JamieTaylor23/Adjustabike/Cargo Attachment/README

Contains all joints for cargo attachment
