JamieTaylor23/Adjustabike/Front Fork/Front Fork/Fork Crown main.stp

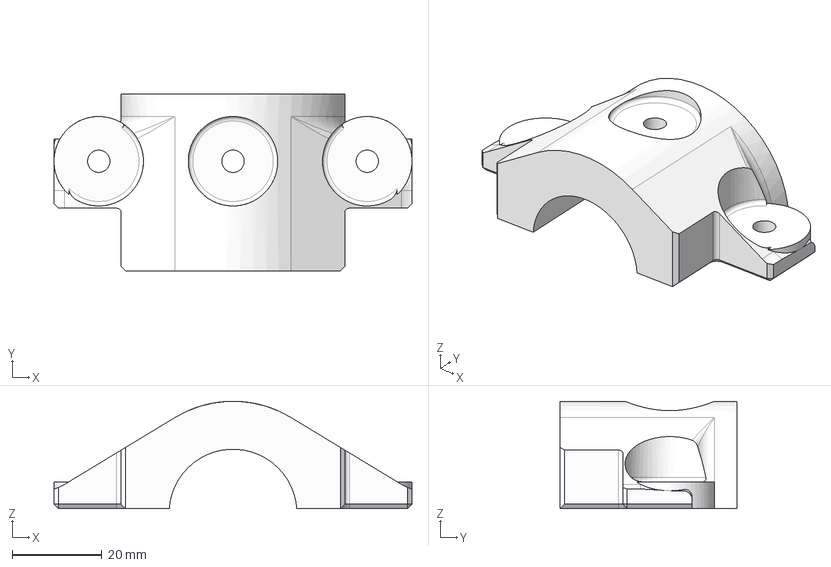
[picture p5: CAD file, 2019-04-16]
Front Fork/Front Fork/Fork Crown main.stp
80.0 x 39.5 x 24.0 mm
