JamieTaylor23/Adjustabike/Cargo Attachment/Cargo Attachment/Bottom Plate.stp

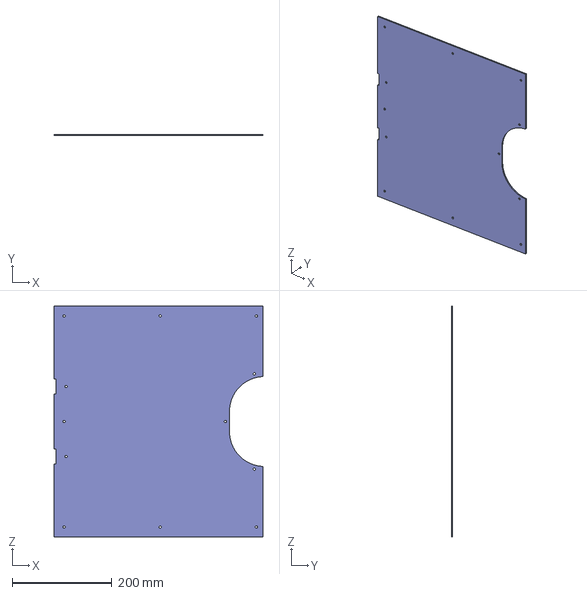
[picture p6: CAD file, 2019-04-16]
Cargo Attachment/Cargo Attachment/Bottom Plate.stp
418.0 x 3.00 x 462.2 mm
