JamieTaylor23/Adjustabike/Down Tube Assembly/Down Tube Assembly/middle adjustable connector.stp

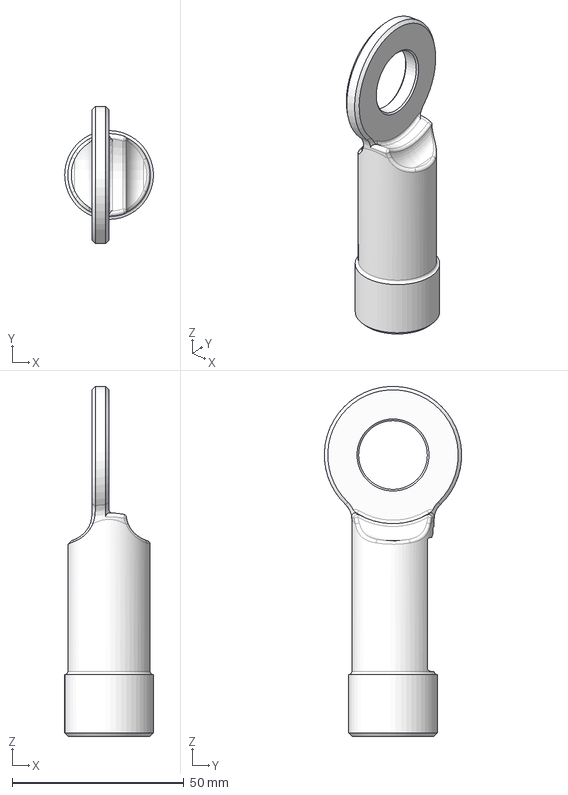
[picture p7: CAD file, 2019-04-16]
Down Tube Assembly/Down Tube Assembly/middle adjustable connector.stp
25.8 x 40.0 x 102.0 mm
