JamieTaylor23/Adjustabike/Front Fork/Front Fork/fork end right.stp

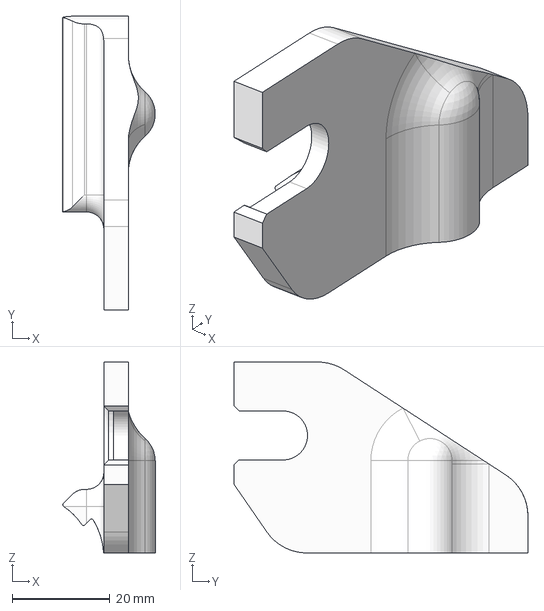
[picture p8: CAD file, 2019-04-16]
Front Fork/Front Fork/fork end right.stp
18.9 x 60.0 x 39.0 mm
