JamieTaylor23/Adjustabike/Profiles/Profiles/Large Tube End.stp

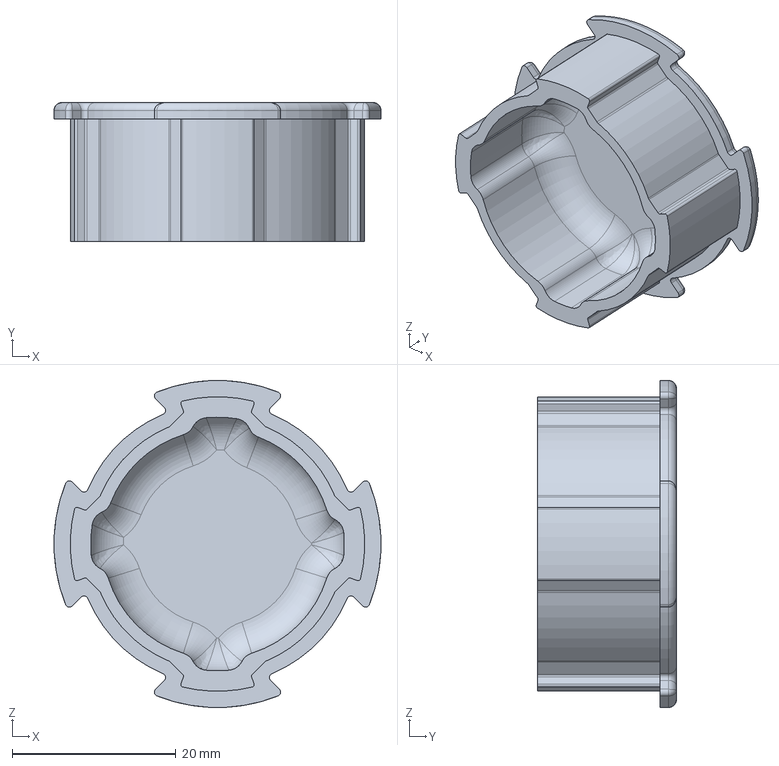
[picture p9: CAD file, 2019-04-16]
Profiles/Profiles/Large Tube End.stp
40.0 x 17.0 x 40.0 mm
