JamieTaylor23/Adjustabike/Rear Triangle/Rear Triangle/Rear Dropouts right clamp.stp

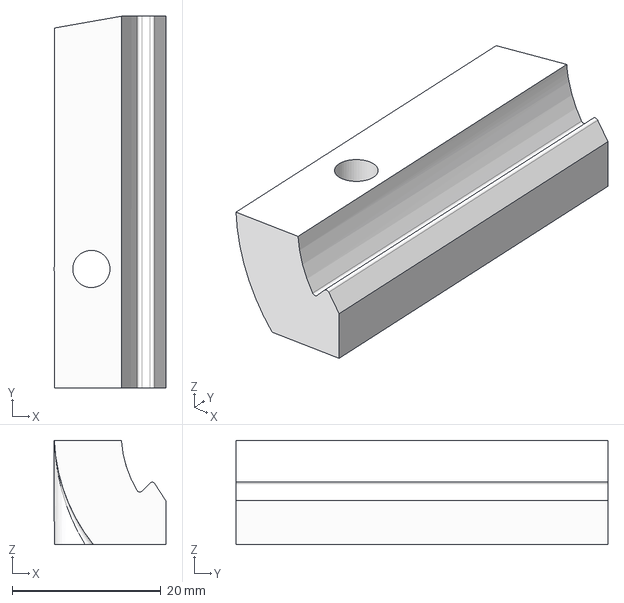
[picture p10: CAD file, 2019-04-16]
Rear Triangle/Rear Triangle/Rear Dropouts right clamp.stp
15.0 x 50.0 x 14.0 mm
