JamieTaylor23/Adjustabike/Seat Tube Assembly/Seat Tube Assembly/bottom bracket to head tube left.stp

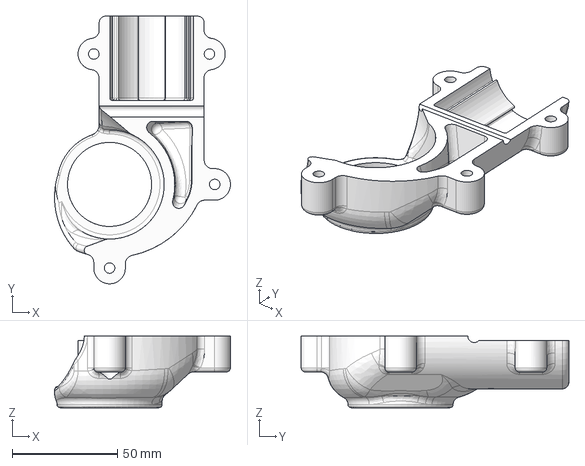
[picture p11: CAD file, 2019-04-16]
Seat Tube Assembly/Seat Tube Assembly/bottom bracket to head tube left.stp
83.7 x 127.3 x 34.0 mm
