JamieTaylor23/Adjustabike/Seat Tube Assembly/standard joint.stp

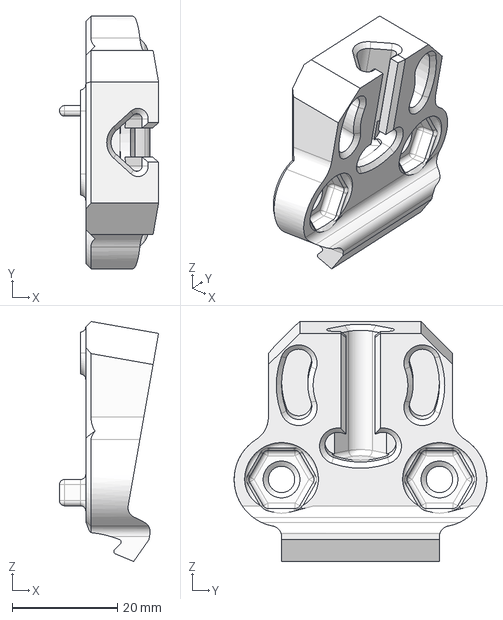
[picture p12: CAD file, 2019-04-16]
Seat Tube Assembly/standard joint.stp
18.8 x 48.0 x 45.6 mm
