JamieTaylor23/Adjustabike/Cargo Attachment/Cargo Attachment/plate support.stp

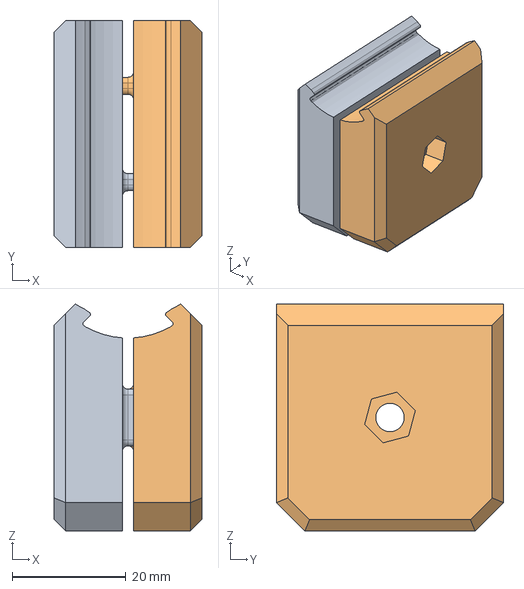
[picture p13: CAD file, 2019-04-16]
Cargo Attachment/Cargo Attachment/plate support.stp
26.0 x 40.0 x 40.0 mm
