JamieTaylor23/Adjustabike/Down Tube Assembly/Down Tube Assembly/Head Tube Mount.stp

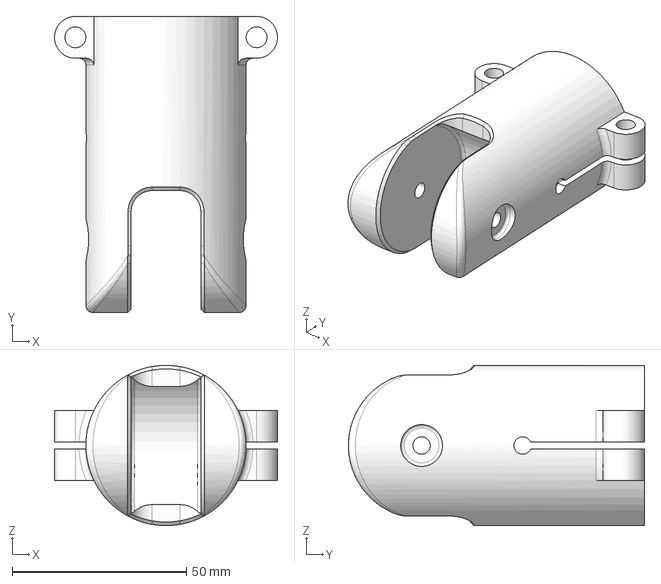
[picture p14: CAD file, 2019-04-16]
Down Tube Assembly/Down Tube Assembly/Head Tube Mount.stp
64.0 x 85.0 x 46.0 mm
