JamieTaylor23/Adjustabike/Front Fork/Front Fork/fork end clamp.stp

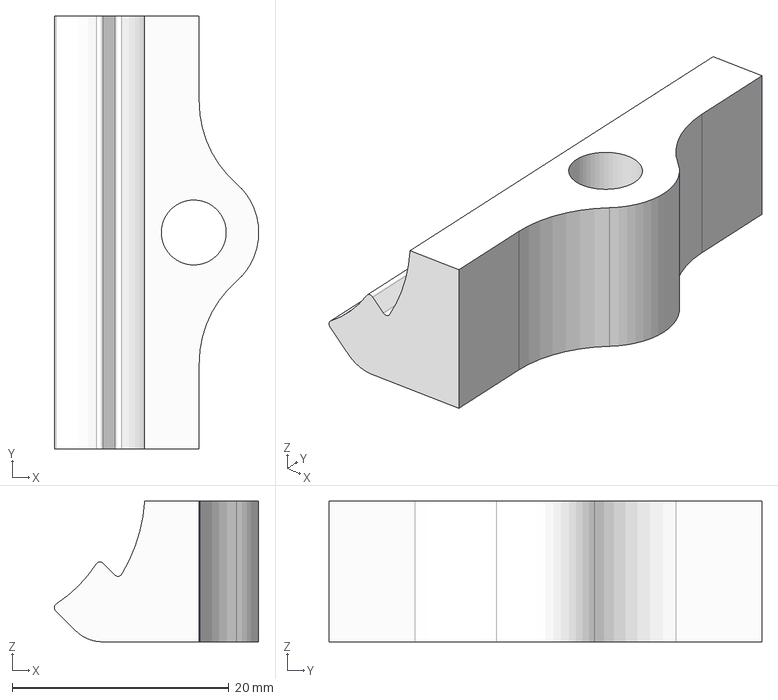
[picture p15: CAD file, 2019-04-16]
Front Fork/Front Fork/fork end clamp.stp
18.9 x 40.0 x 13.0 mm
