JamieTaylor23/Adjustabike/Profiles/Profiles/Handlebar cargo tube.stp

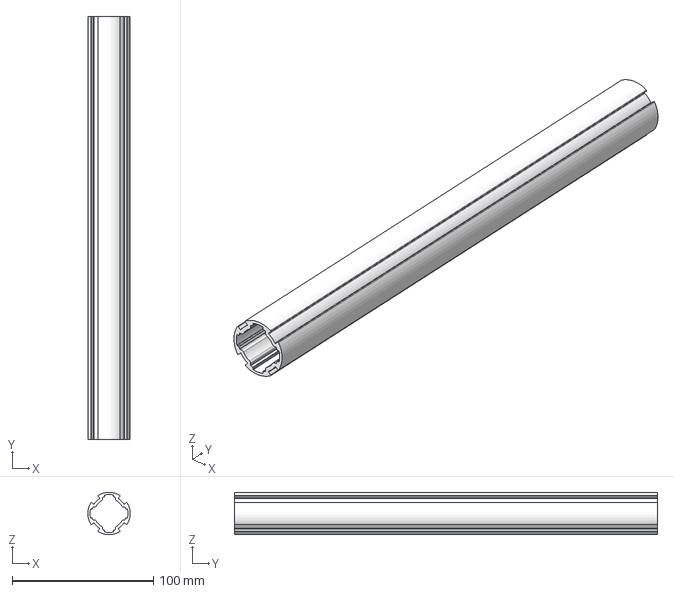
[picture p16: CAD file, 2019-04-16]
Profiles/Profiles/Handlebar cargo tube.stp
29.9 x 300.0 x 29.9 mm
