JamieTaylor23/Adjustabike/Rear Triangle/Rear Triangle/Rear Dropouts left.stp

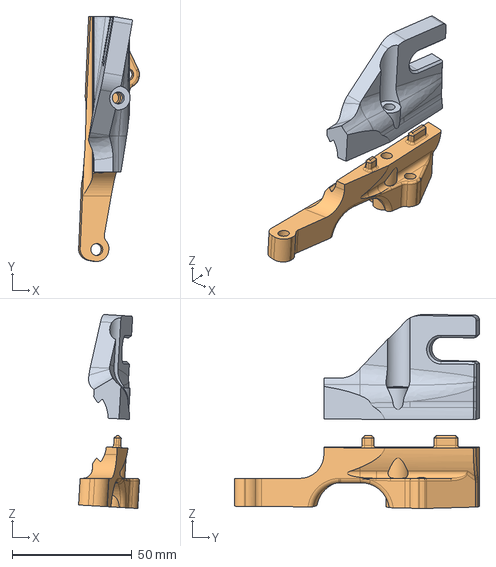
[picture p17: CAD file, 2019-04-16]
Rear Triangle/Rear Triangle/Rear Dropouts left.stp
25.4 x 102.3 x 81.0 mm
