JamieTaylor23/Adjustabike/Seat Tube Assembly/Seat Tube Assembly/Seat tube.stp

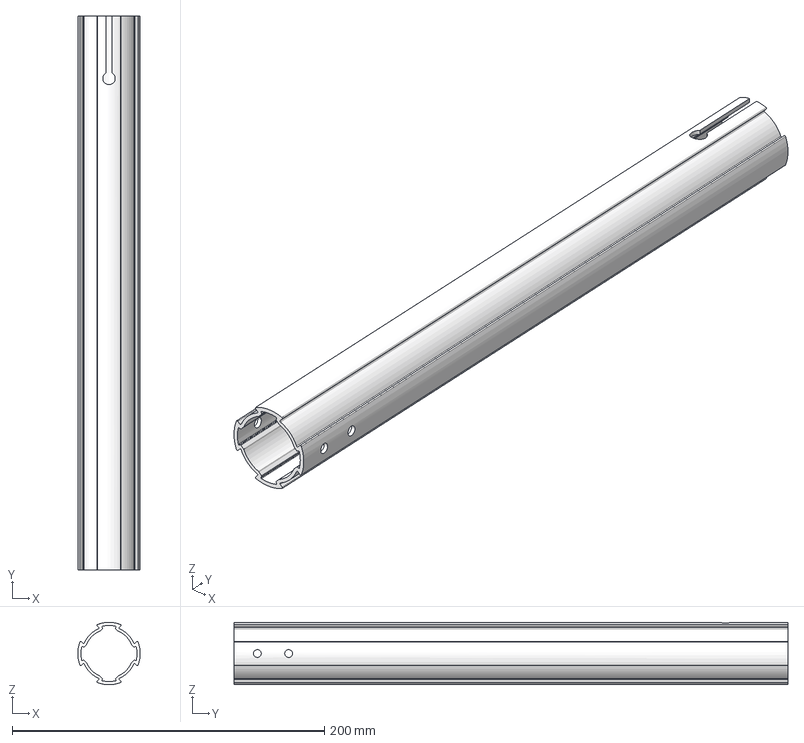
[picture p18: CAD file, 2019-04-16]
Seat Tube Assembly/Seat Tube Assembly/Seat tube.stp
40.0 x 355.0 x 40.0 mm
