JamieTaylor23/Adjustabike/Cargo Attachment/Cargo Attachment/Front plate.stp

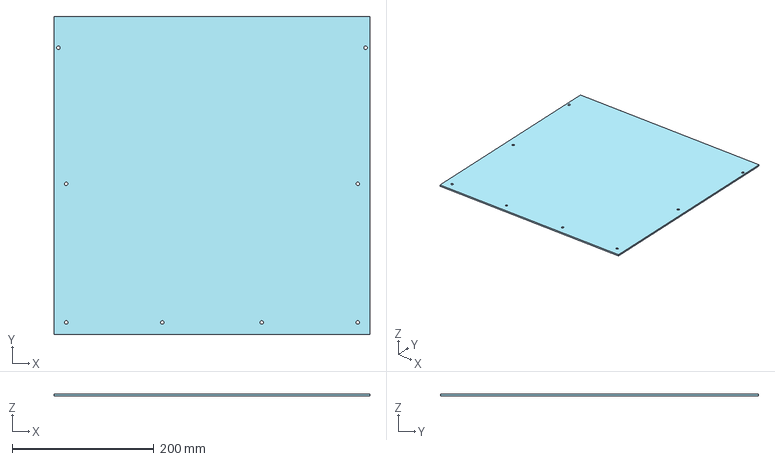
[picture p19: CAD file, 2019-04-16]
Cargo Attachment/Cargo Attachment/Front plate.stp
444.8 x 448.0 x 3.00 mm
