JamieTaylor23/Adjustabike/Down Tube Assembly/Down Tube Assembly/adjustable bar joint.stp

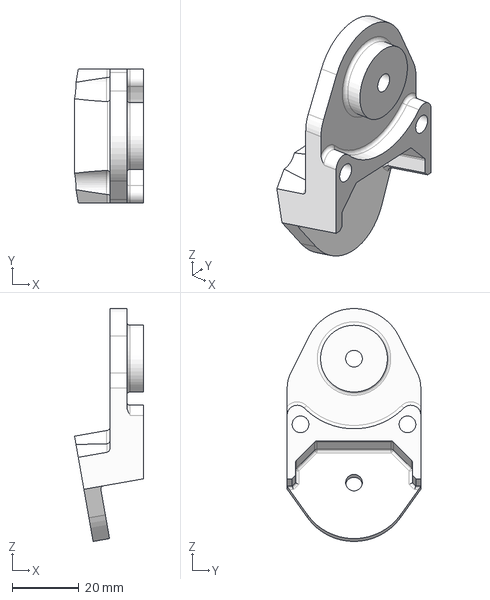
[picture p20: CAD file, 2019-04-16]
Down Tube Assembly/Down Tube Assembly/adjustable bar joint.stp
20.6 x 40.0 x 69.7 mm
