JamieTaylor23/Adjustabike/Front Fork/Front Fork/Fork Crown clamp 3.stp

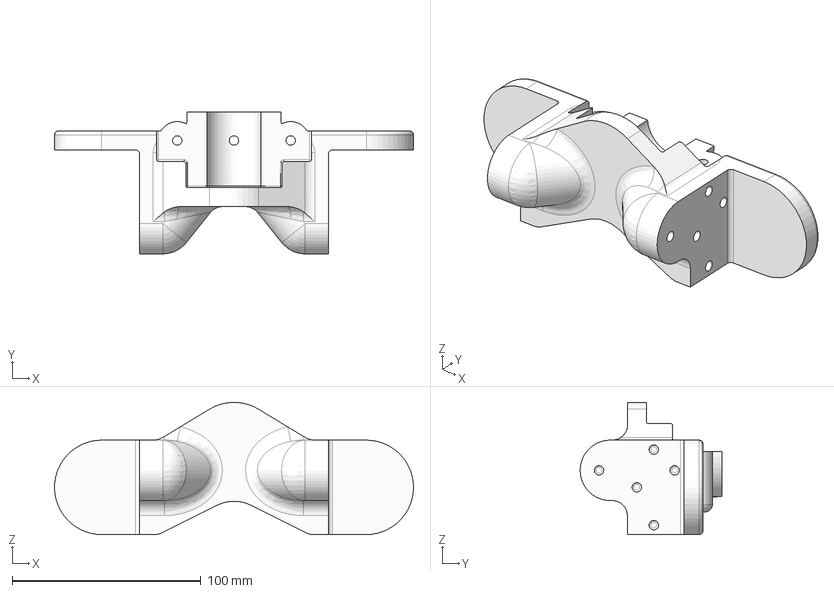
[picture p21: CAD file, 2019-04-16]
Front Fork/Front Fork/Fork Crown clamp 3.stp
190.0 x 75.0 x 70.0 mm
