JamieTaylor23/Adjustabike/Profiles/Profiles/Cargo Long tube.stp

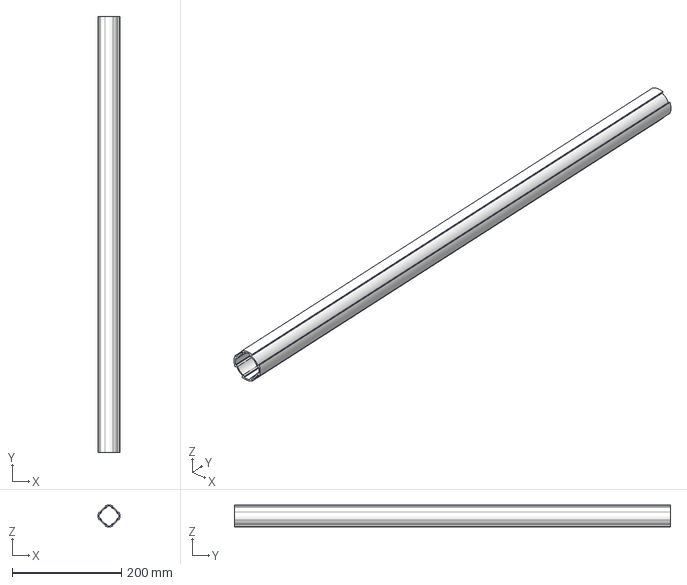
[picture p22: CAD file, 2019-04-16]
Profiles/Profiles/Cargo Long tube.stp
39.9 x 800.0 x 39.9 mm
