JamieTaylor23/Adjustabike/Rear Triangle/Rear Triangle/Rear stay joint.stp

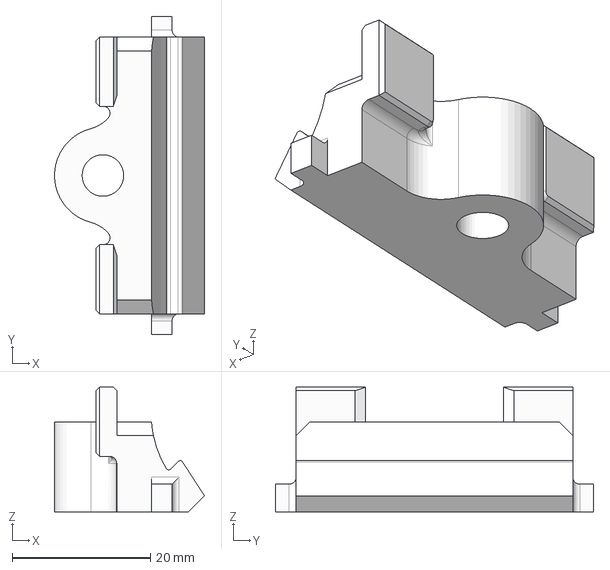
[picture p23: CAD file, 2019-04-16]
Rear Triangle/Rear Triangle/Rear stay joint.stp
21.7 x 46.0 x 18.0 mm
