JamieTaylor23/Adjustabike/Seat Tube Assembly/Seat Tube Assembly/seat tube insert.stp

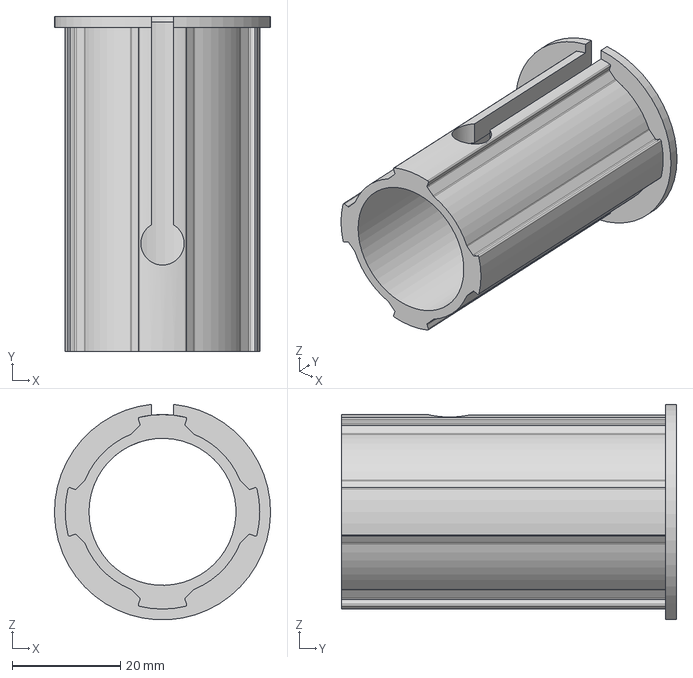
[picture p24: CAD file, 2019-04-16]
Seat Tube Assembly/Seat Tube Assembly/seat tube insert.stp
40.0 x 62.0 x 39.9 mm
