JamieTaylor23/Adjustabike/Cargo Attachment/Cargo Attachment/Plate spacer.stp

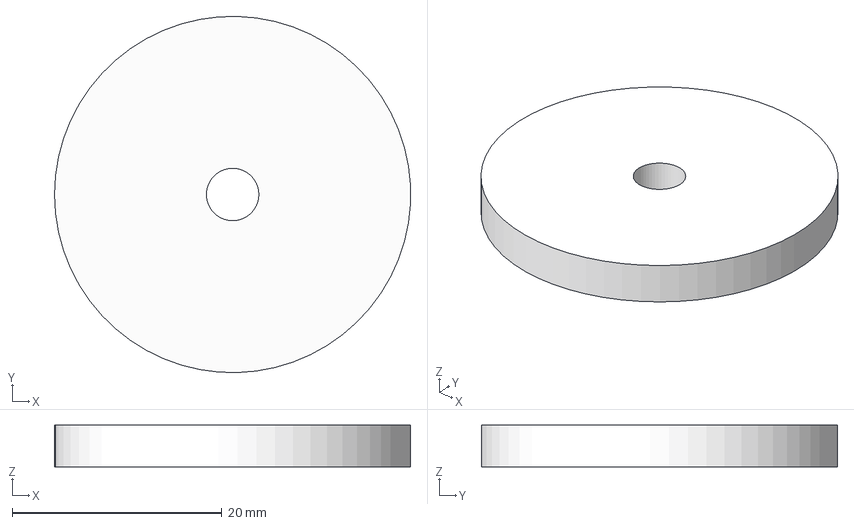
[picture p25: CAD file, 2019-04-16]
Cargo Attachment/Cargo Attachment/Plate spacer.stp
34.0 x 34.0 x 4.00 mm
