JamieTaylor23/Adjustabike/Down Tube Assembly/Down Tube Assembly/Head Tube.stp

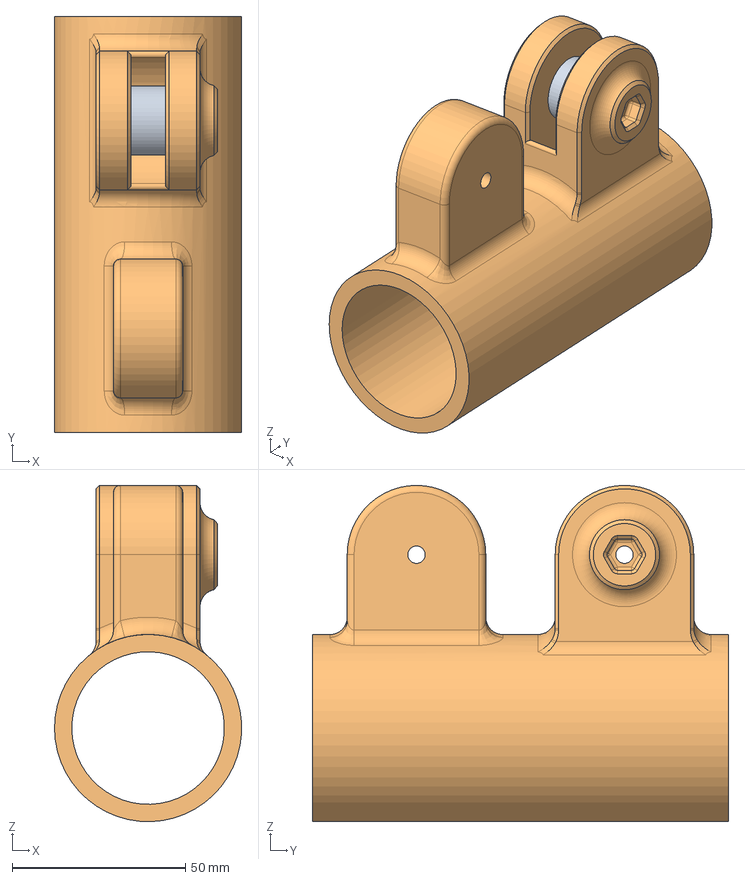
[picture p26: CAD file, 2019-04-16]
Down Tube Assembly/Down Tube Assembly/Head Tube.stp
53.9 x 120.0 x 97.0 mm
