JamieTaylor23/Adjustabike/Front Fork/Front Fork/brake boss clamp.stp

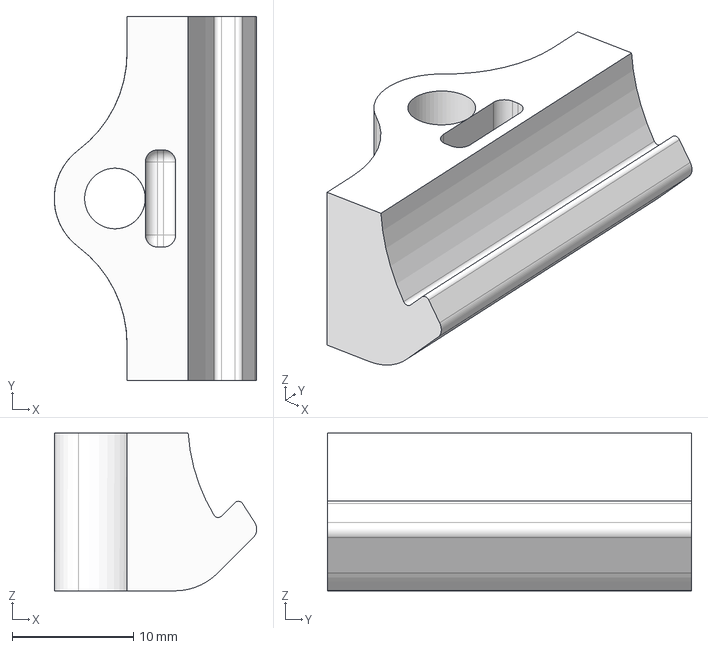
[picture p27: CAD file, 2019-04-16]
Front Fork/Front Fork/brake boss clamp.stp
16.7 x 30.0 x 13.0 mm
