JamieTaylor23/Adjustabike/Profiles/Profiles/Small Tube End.stp

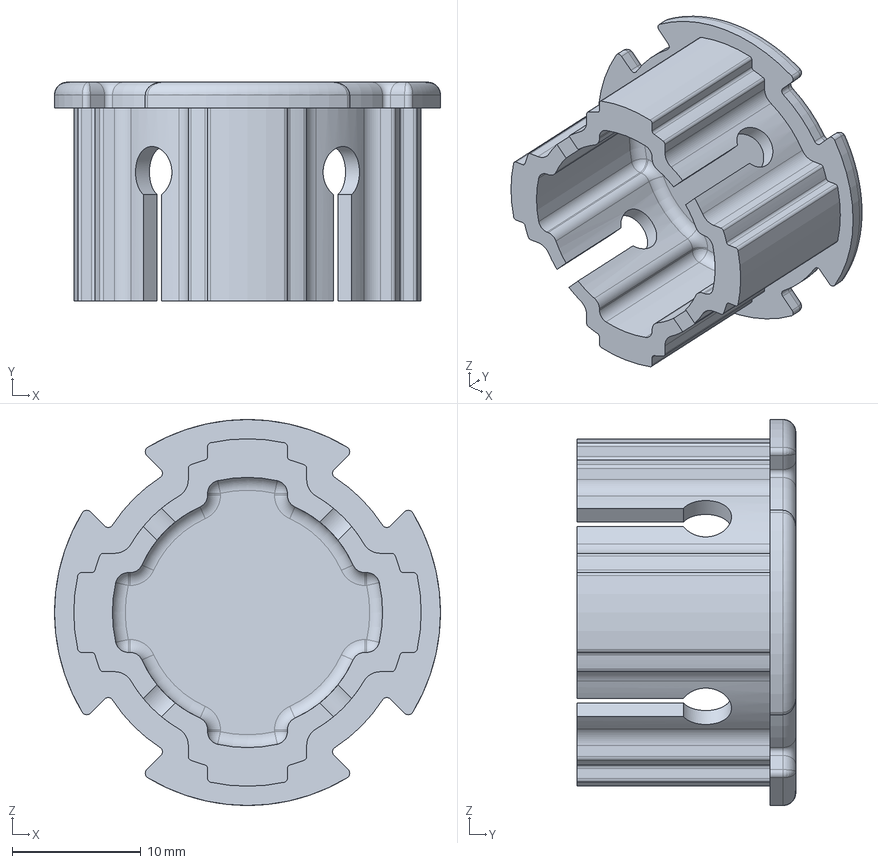
[picture p28: CAD file, 2019-04-16]
Profiles/Profiles/Small Tube End.stp
30.0 x 17.0 x 30.0 mm
