JamieTaylor23/Adjustabike/Rear Triangle/Rear Triangle/Rear Dropouts right.stp

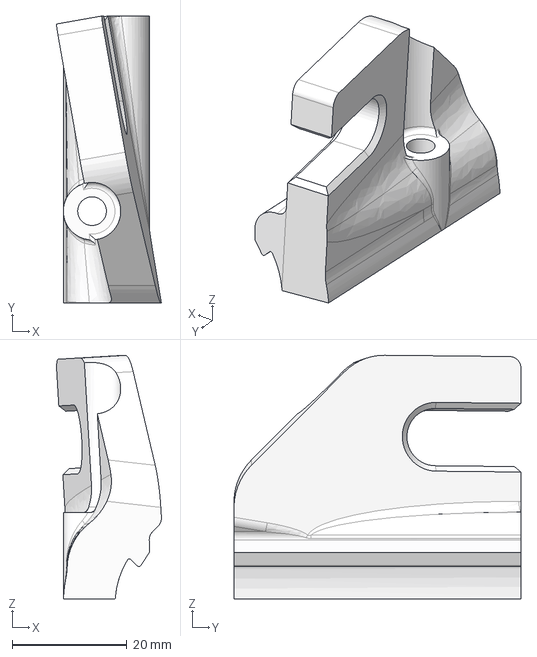
[picture p29: CAD file, 2019-04-16]
Rear Triangle/Rear Triangle/Rear Dropouts right.stp
18.3 x 50.0 x 42.4 mm
