JamieTaylor23/Adjustabike/Seat Tube Assembly/Seat Tube Assembly/bottom bracket.stp

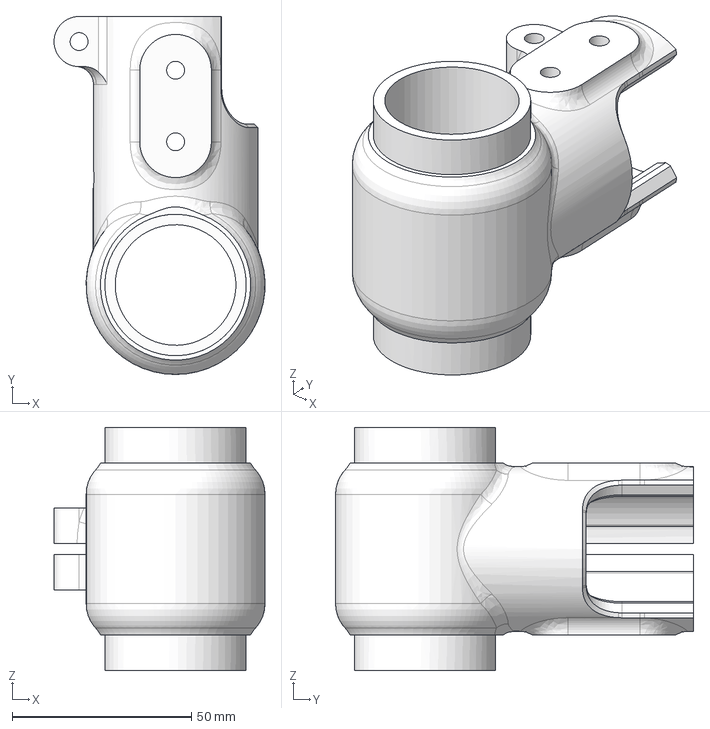
[picture p30: CAD file, 2019-04-16]
Seat Tube Assembly/Seat Tube Assembly/bottom bracket.stp
58.9 x 100.0 x 68.0 mm
