JamieTaylor23/Adjustabike/Cargo Attachment/Cargo Attachment/Step Plate.stp

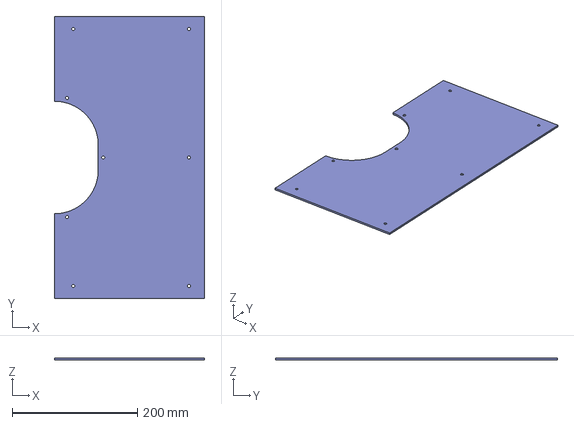
[picture p31: CAD file, 2019-04-16]
Cargo Attachment/Cargo Attachment/Step Plate.stp
240.0 x 451.2 x 3.00 mm
