JamieTaylor23/Adjustabike/Down Tube Assembly/Down Tube Assembly/Head Tube Plug.stp

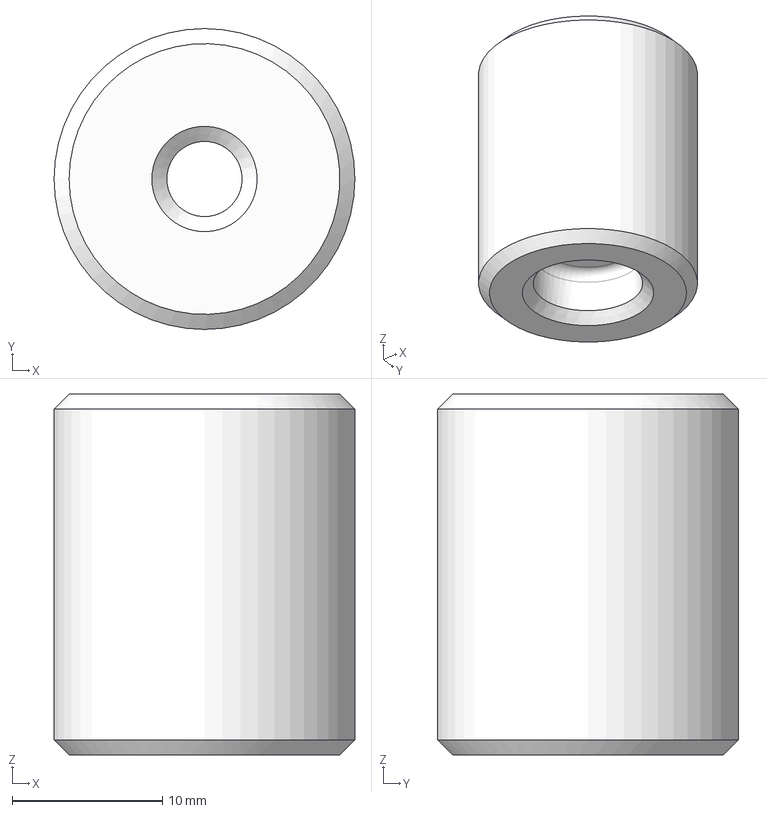
[picture p32: CAD file, 2019-04-16]
Down Tube Assembly/Down Tube Assembly/Head Tube Plug.stp
20.0 x 20.0 x 24.0 mm
