JamieTaylor23/Adjustabike/Profiles/Profiles/450mm tube.stp

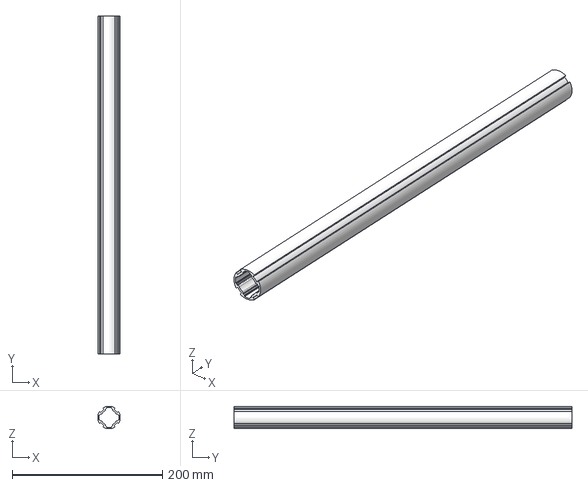
[picture p33: CAD file, 2019-04-16]
Profiles/Profiles/450mm tube.stp
29.9 x 450.0 x 29.9 mm
