JamieTaylor23/Adjustabike/Rear Triangle/Rear Triangle/Rear stay joint clamp.stp

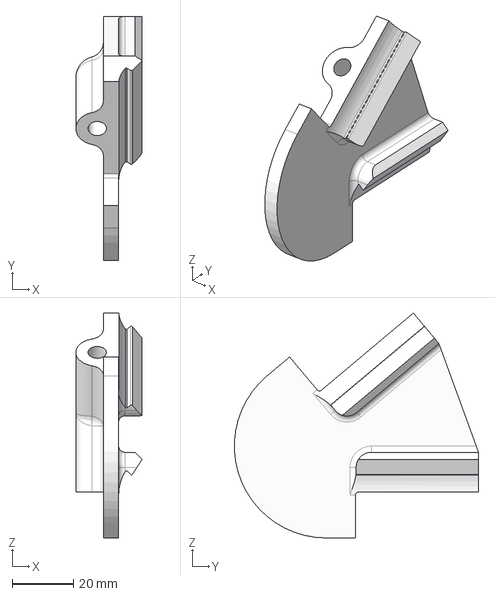
[picture p34: CAD file, 2019-04-16]
Rear Triangle/Rear Triangle/Rear stay joint clamp.stp
21.7 x 79.7 x 73.5 mm
