JamieTaylor23/Adjustabike/Seat Tube Assembly/Seat Tube Assembly/seat stay attachment.stp

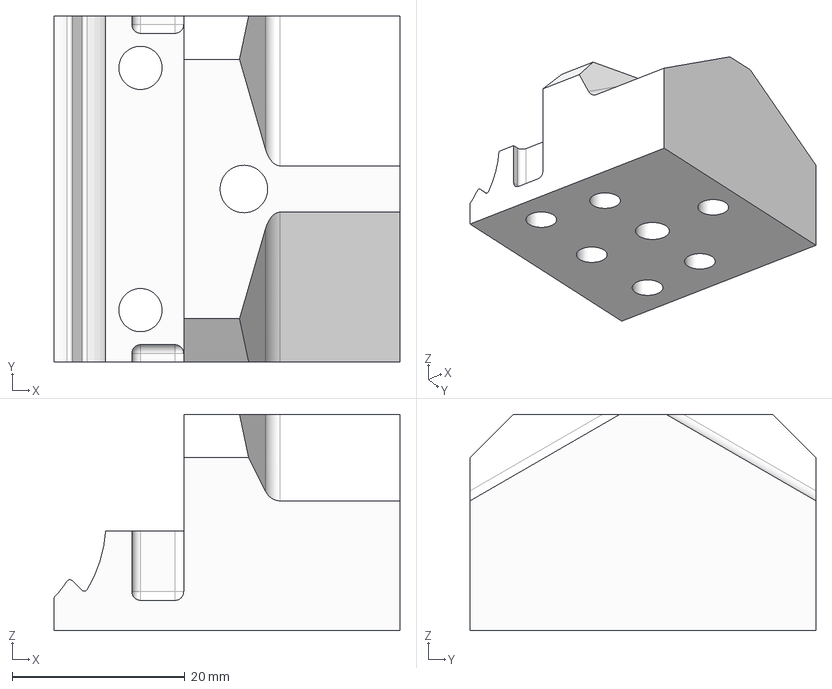
[picture p35: CAD file, 2019-04-16]
Seat Tube Assembly/Seat Tube Assembly/seat stay attachment.stp
40.0 x 40.0 x 25.0 mm
