JamieTaylor23/Adjustabike/Cargo Attachment/Cargo Attachment/side panel.stp

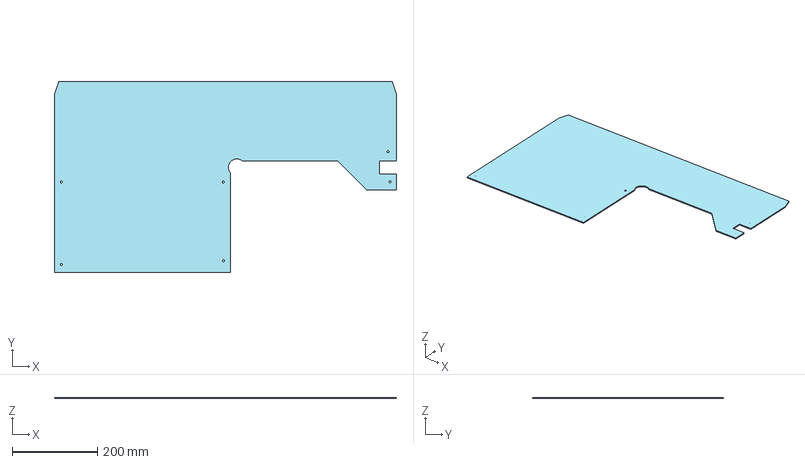
[picture p36: CAD file, 2019-04-16]
Cargo Attachment/Cargo Attachment/side panel.stp
804.2 x 448.0 x 3.00 mm
