JamieTaylor23/Adjustabike/Down Tube Assembly/Down Tube Assembly/adjustable top bar.stp

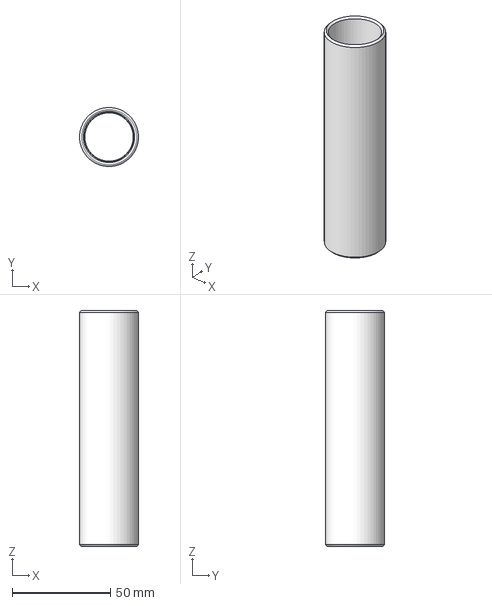
[picture p37: CAD file, 2019-04-16]
Down Tube Assembly/Down Tube Assembly/adjustable top bar.stp
30.0 x 30.0 x 120.0 mm
