JamieTaylor23/Adjustabike/Front Fork/Front Fork/steering column.stp

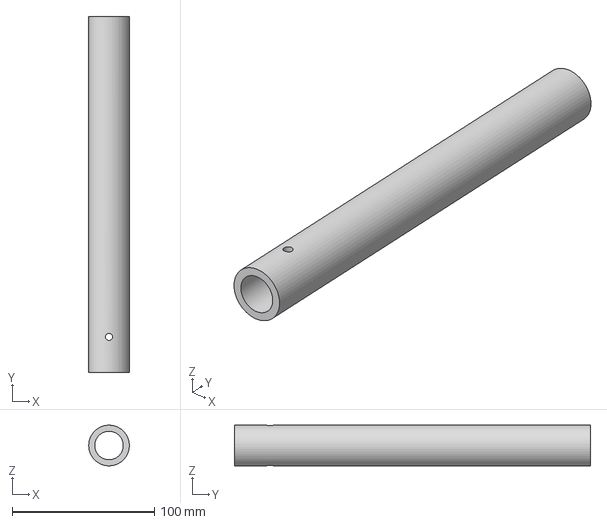
[picture p38: CAD file, 2019-04-16]
Front Fork/Front Fork/steering column.stp
28.5 x 250.0 x 28.6 mm
