JamieTaylor23/Adjustabike/Profiles/Profiles/Down tube.stp

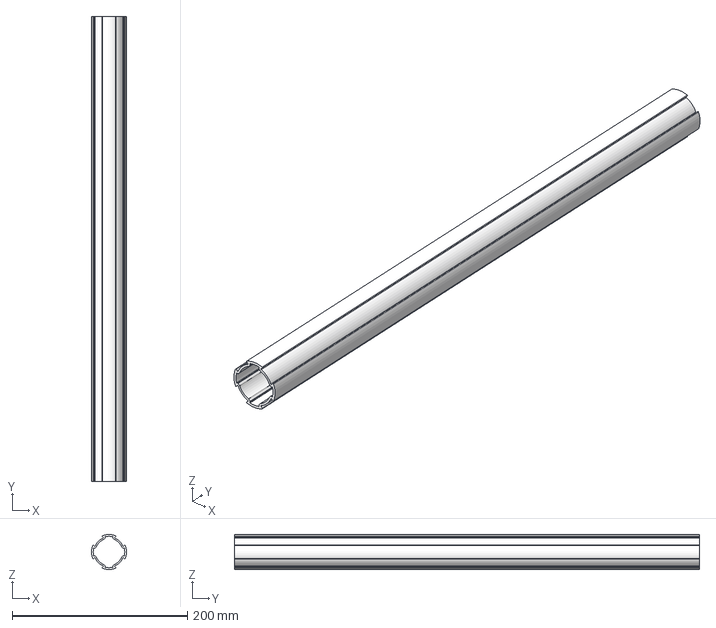
[picture p39: CAD file, 2019-04-16]
Profiles/Profiles/Down tube.stp
39.9 x 530.0 x 39.9 mm
