JamieTaylor23/Adjustabike/Seat Tube Assembly/Seat Tube Assembly/seat stay attachment 2.stp

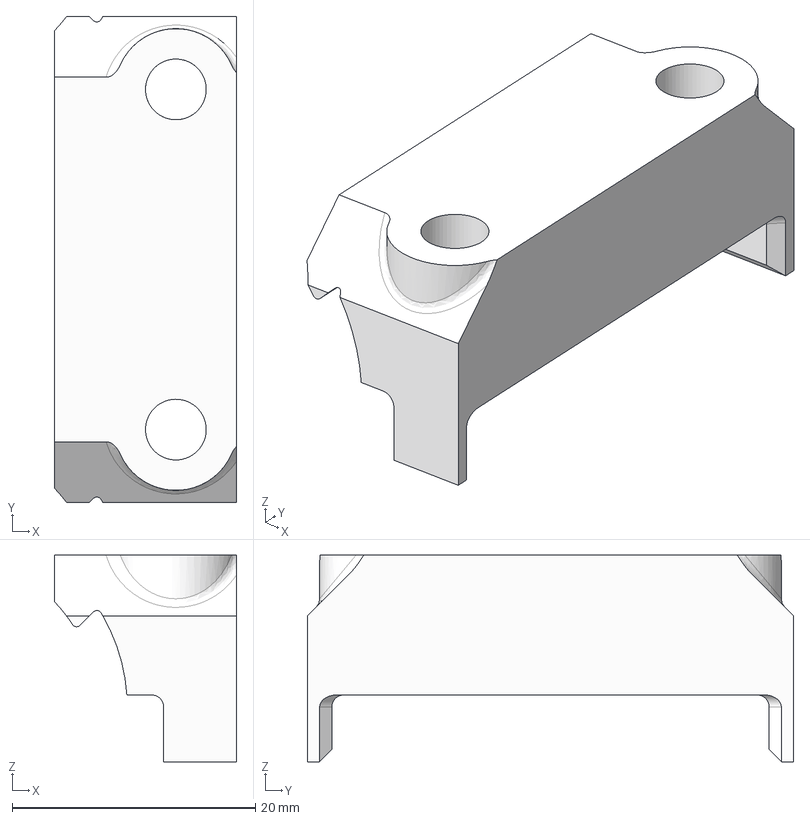
[picture p40: CAD file, 2019-04-16]
Seat Tube Assembly/Seat Tube Assembly/seat stay attachment 2.stp
15.0 x 40.0 x 17.0 mm
