JamieTaylor23/Adjustabike/Cargo Attachment/Cargo Attachment/Top Plate.stp

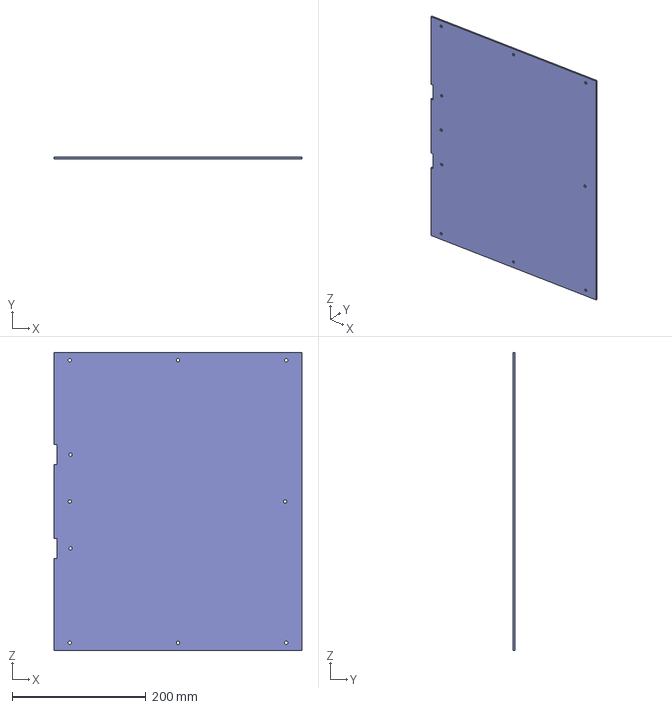
[picture p41: CAD file, 2019-04-16]
Cargo Attachment/Cargo Attachment/Top Plate.stp
370.1 x 3.00 x 445.2 mm
