JamieTaylor23/Adjustabike/Down Tube Assembly/Down Tube Assembly/adjustable top bar long.stp

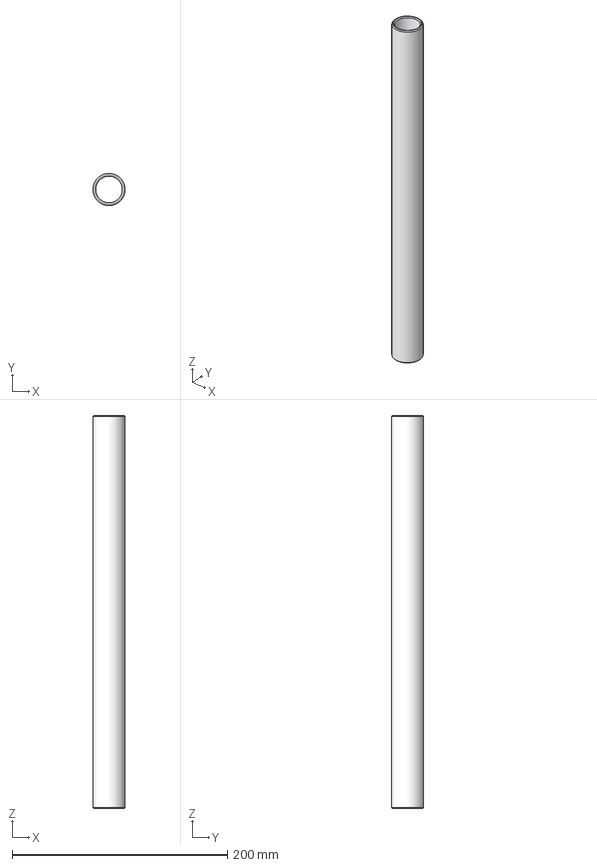
[picture p42: CAD file, 2019-04-16]
Down Tube Assembly/Down Tube Assembly/adjustable top bar long.stp
30.0 x 30.0 x 365.0 mm
