JamieTaylor23/Adjustabike/Front Fork/Front Fork/Fork Crown clamp 1.stp

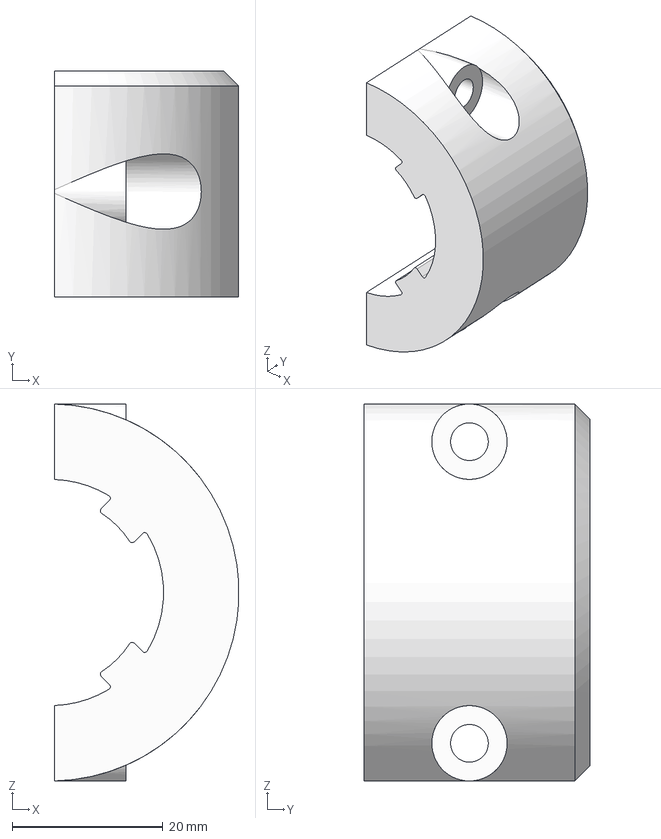
[picture p43: CAD file, 2019-04-16]
Front Fork/Front Fork/Fork Crown clamp 1.stp
24.5 x 30.0 x 50.0 mm
