JamieTaylor23/Adjustabike/Cargo Attachment/Cargo Attachment/Back Plate.stp

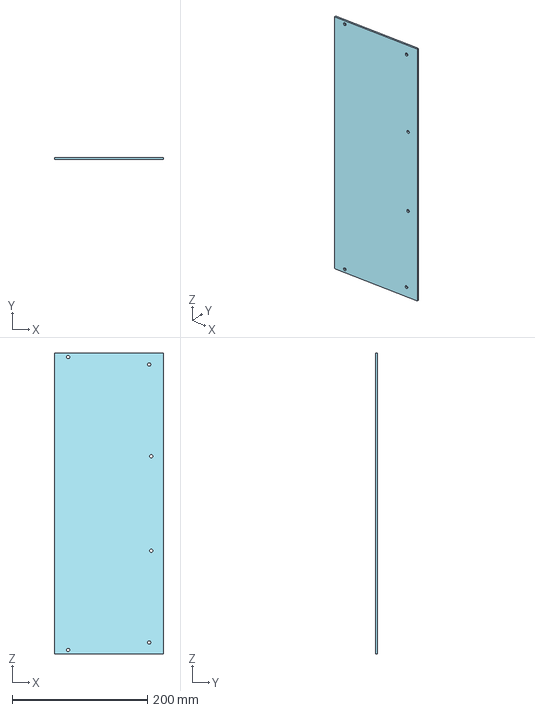
[picture p44: CAD file, 2019-04-16]
Cargo Attachment/Cargo Attachment/Back Plate.stp
161.0 x 3.00 x 445.2 mm
