JamieTaylor23/Adjustabike/Down Tube Assembly/Down Tube Assembly/Adjustable outer connector.stp

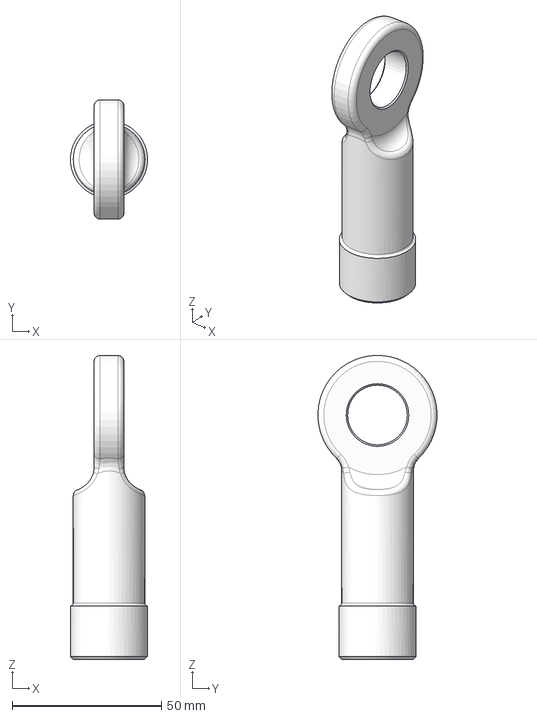
[picture p45: CAD file, 2019-04-16]
Down Tube Assembly/Down Tube Assembly/Adjustable outer connector.stp
25.9 x 40.0 x 102.0 mm
