JamieTaylor23/Adjustabike/Seat Tube Assembly/Seat Tube Assembly/Seat Post Clamp.stp

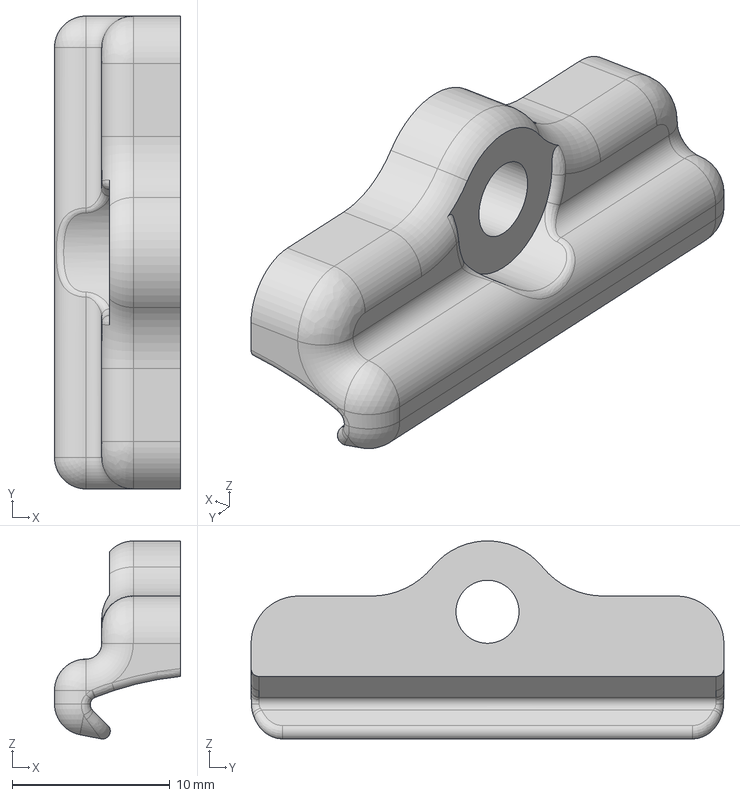
[picture p46: CAD file, 2019-04-16]
Seat Tube Assembly/Seat Tube Assembly/Seat Post Clamp.stp
8.00 x 30.0 x 12.6 mm
