JamieTaylor23/Adjustabike/Cargo Attachment/Cargo Attachment/90 fastner.stp

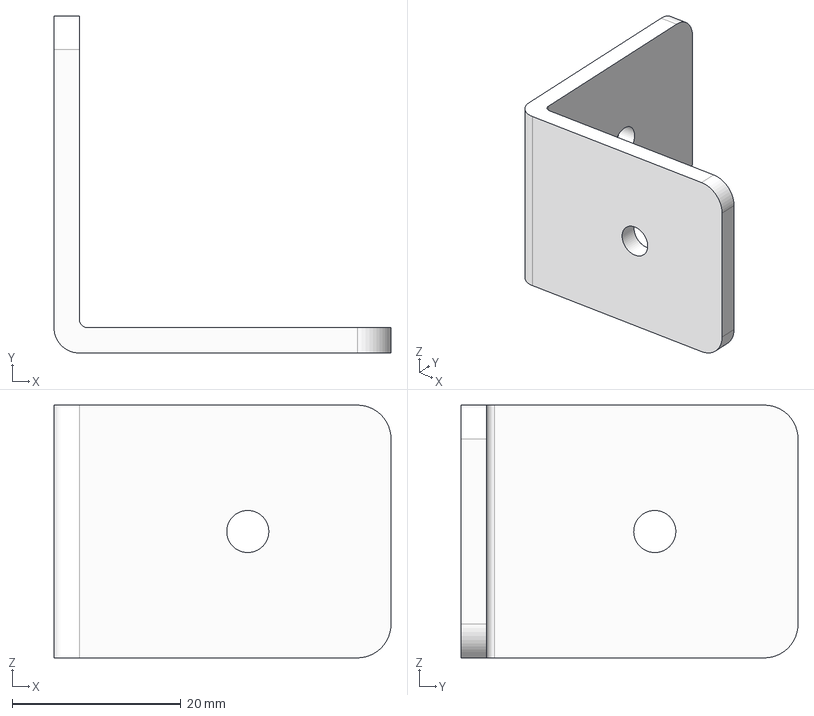
[picture p47: CAD file, 2019-04-16]
Cargo Attachment/Cargo Attachment/90 fastner.stp
40.0 x 40.0 x 30.0 mm
