JamieTaylor23/Adjustabike/Front Fork/Front Fork/brake boss top.stp

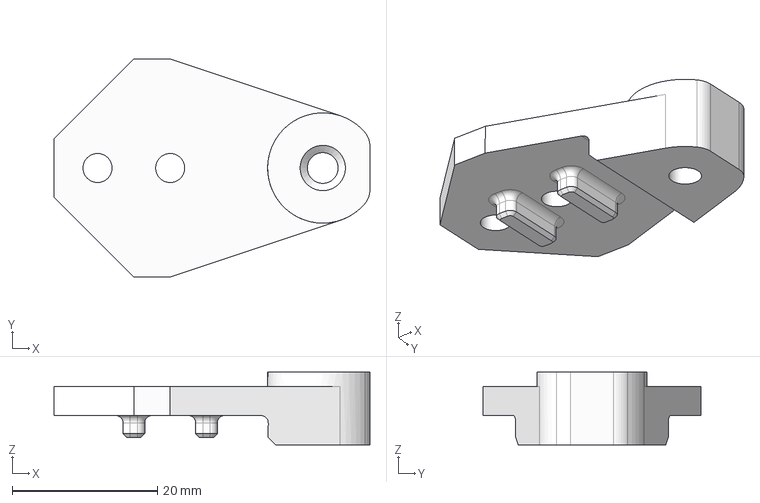
[picture p48: CAD file, 2019-04-16]
Front Fork/Front Fork/brake boss top.stp
43.5 x 30.0 x 10.0 mm
