JamieTaylor23/Adjustabike/Cargo Attachment/Cargo Attachment/Middle Cargo Bracket.stp

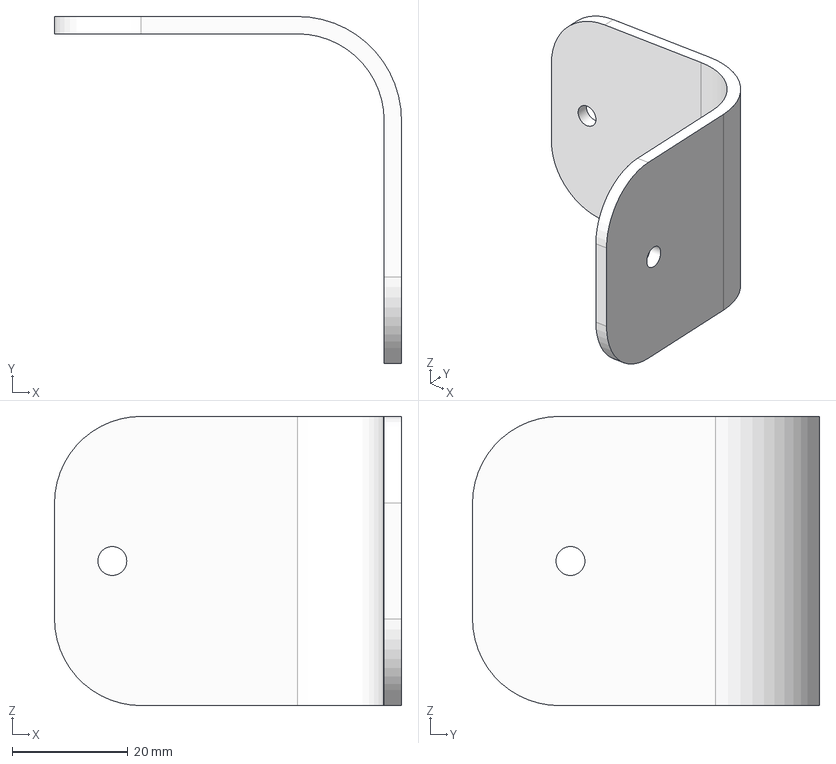
[picture p49: CAD file, 2019-04-16]
Cargo Attachment/Cargo Attachment/Middle Cargo Bracket.stp
60.0 x 60.0 x 50.0 mm
