JamieTaylor23/Adjustabike/Front Fork/Front Fork/brake boss.stp

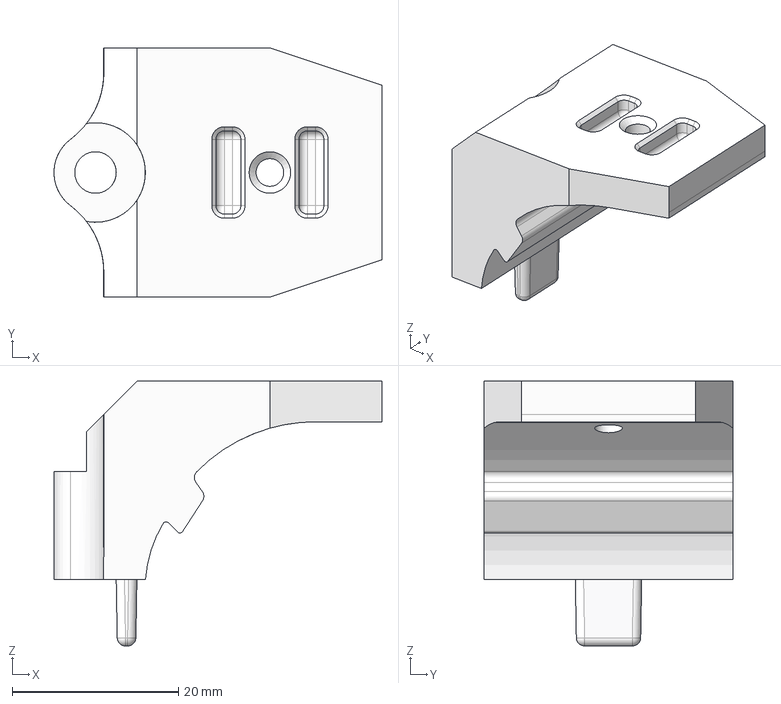
[picture p50: CAD file, 2019-04-16]
Front Fork/Front Fork/brake boss.stp
39.5 x 30.0 x 31.9 mm
