JamieTaylor23/Adjustabike/Cargo Attachment/Cargo Attachment/90 joint.stp

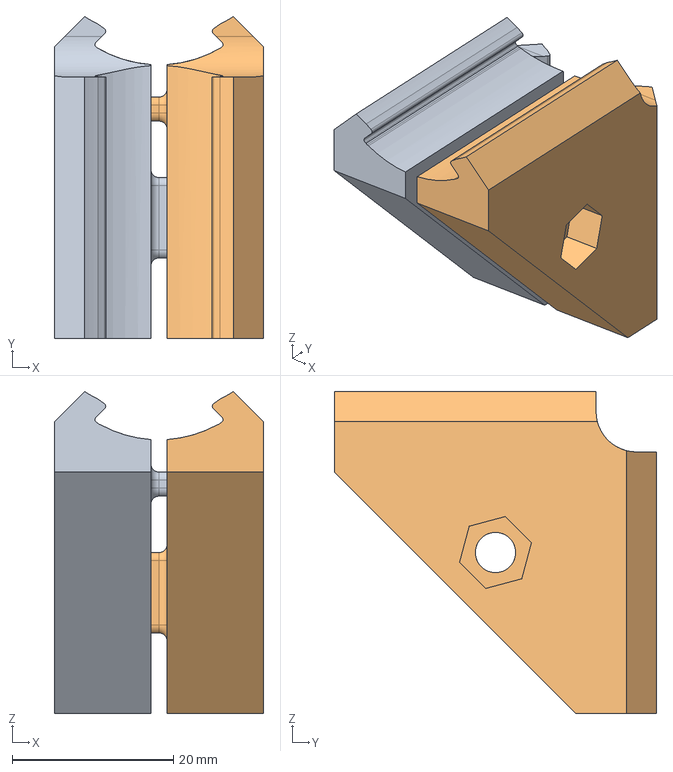
[picture p51: CAD file, 2019-04-16]
Cargo Attachment/Cargo Attachment/90 joint.stp
26.0 x 40.0 x 40.0 mm
