JamieTaylor23/Adjustabike/Front Fork/Front Fork/Fork Crown clamp 2.stp

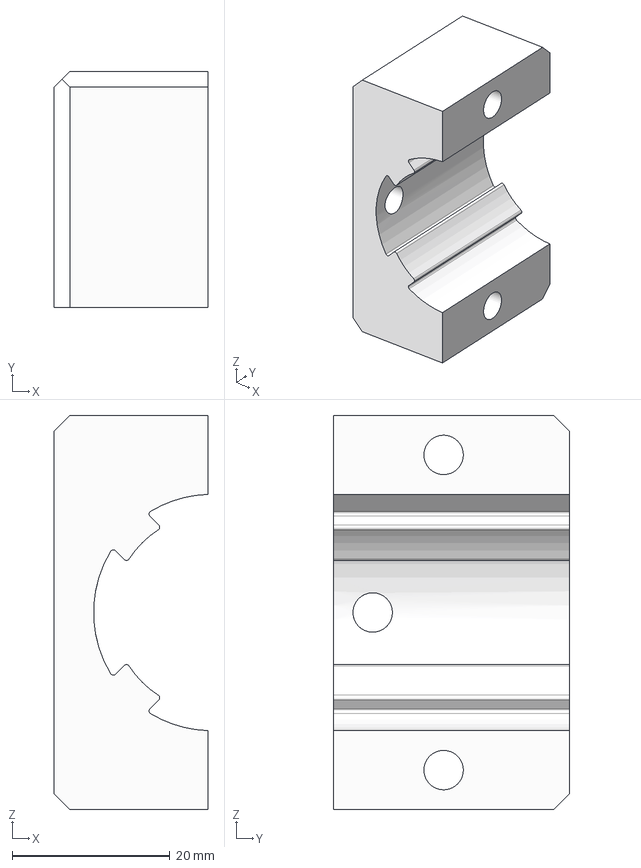
[picture p52: CAD file, 2019-04-16]
Front Fork/Front Fork/Fork Crown clamp 2.stp
19.5 x 30.0 x 50.0 mm
