JamieTaylor23/Adjustabike/Cargo Attachment/Cargo Attachment/rounded plate.stp

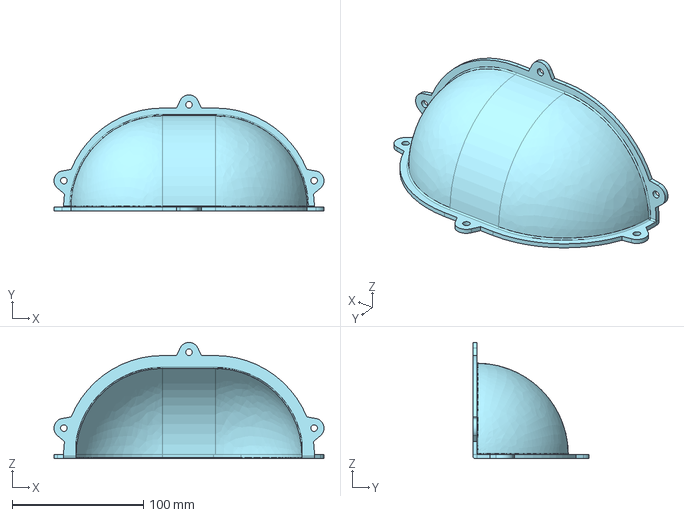
[picture p53: CAD file, 2019-04-16]
Cargo Attachment/Cargo Attachment/rounded plate.stp
205.7 x 88.5 x 88.5 mm
