JamieTaylor23/Adjustabike/(list of files, cad)

Other CAD files:
Seat Tube Assembly/Seat Tube Assembly/bottom bracket to head tube right.stp
Front Fork/Front Fork/fork end left.stp
