JamieTaylor23/Adjustabike/Assembly Drawings.pdf

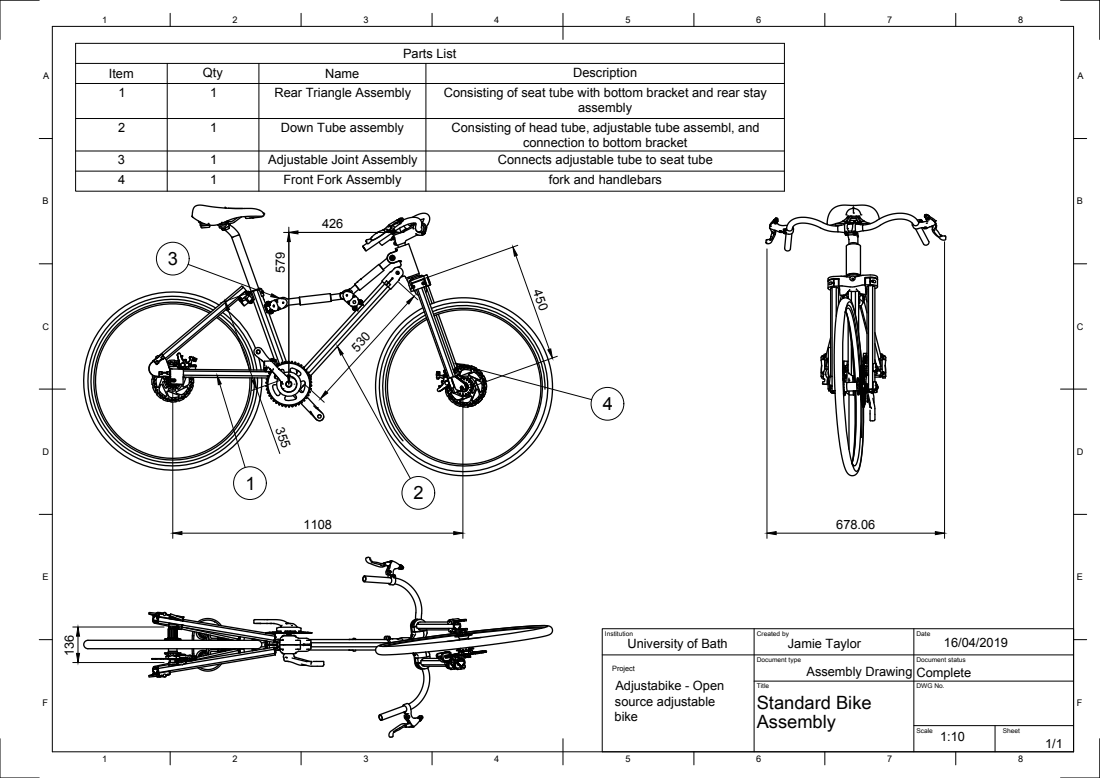
[picture p54: page 1]
Parts List; Item; Qty; Name; Description; Rear Triangle Assembly; Consisting of seat tube with bottom bracket and rear stay; assembly; Down Tube assembly; Consisting of head tube, adjustable tube assembl, and; Adjustable Joint Assembly; Connects adjustable tube to seat tube; Front Fork Assembly; fork and handlebars; Institution; Created by; Date; Document type; Document status; Title; DWG No.; Scale; Sheet; University of Bath; Jamie Taylor; Assembly Drawing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

connection to bottom bracket

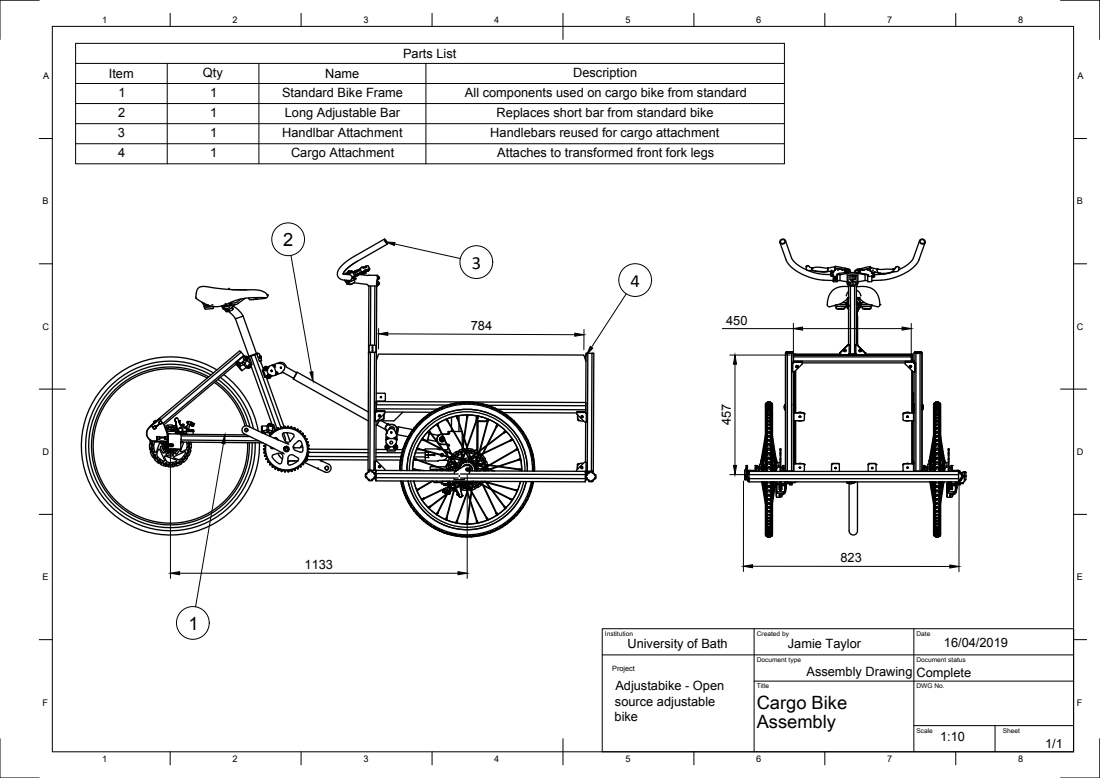
[picture p55: page 2]
Item; Qty; Name; Description; Standard Bike Frame; All components used on cargo bike from standard; Long Adjustable Bar; Replaces short bar from standard bike; Handlbar Attachment; Handlebars reused for cargo attachment; Cargo Attachment; Attaches to transformed front fork legs; Institution; Created by; Date; Document type; Document status; Title; DWG No.; University of Bath; Jamie Taylor; Assembly Drawing; Project Adjustabike - Open source adjustable; Complete; Cargo Bike

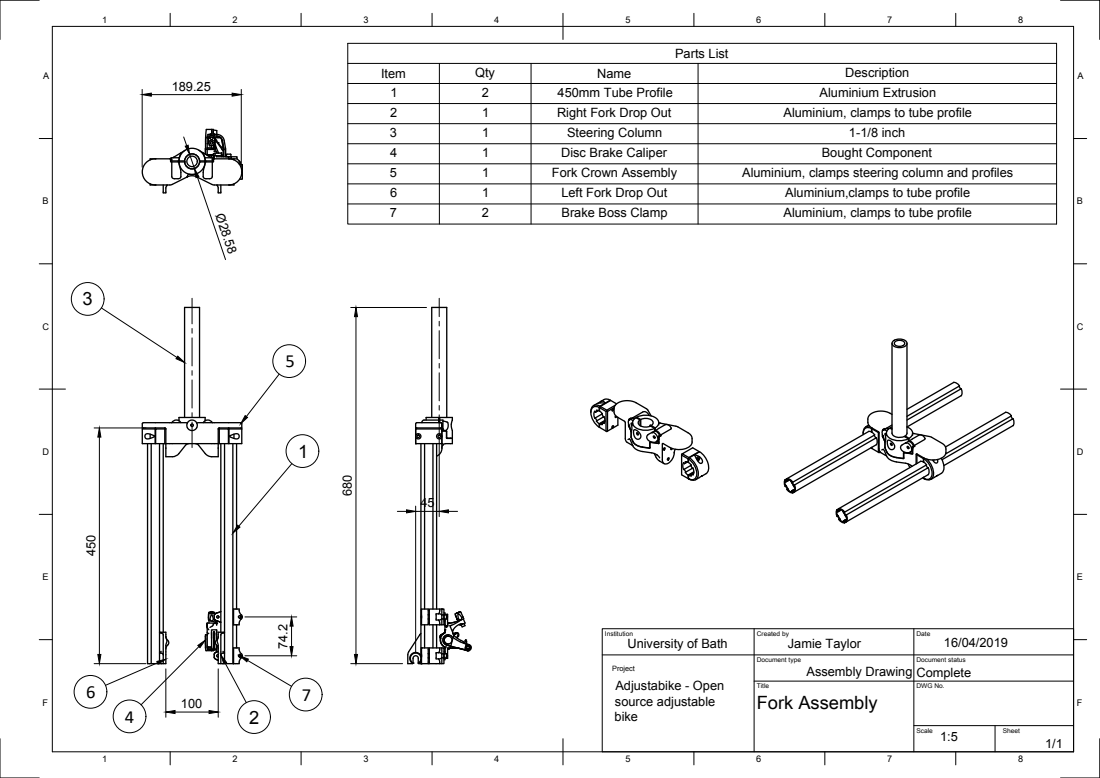
[picture p56: page 3]
Item; Qty; Name; Description; 450mm Tube Profile; Aluminium Extrusion; Right Fork Drop Out; Aluminium, clamps to tube profile; Steering Column; 1-1/8 inch; Disc Brake Caliper; Bought Component; Fork Crown Assembly; Aluminium, clamps steering column and profiles; Left Fork Drop Out; Aluminium,clamps to tube profile; Brake Boss Clamp; Institution; Created by; Date; Document type; Document status; Title; DWG No.; University of Bath; Jamie Taylor; Assembly Drawing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

2

5

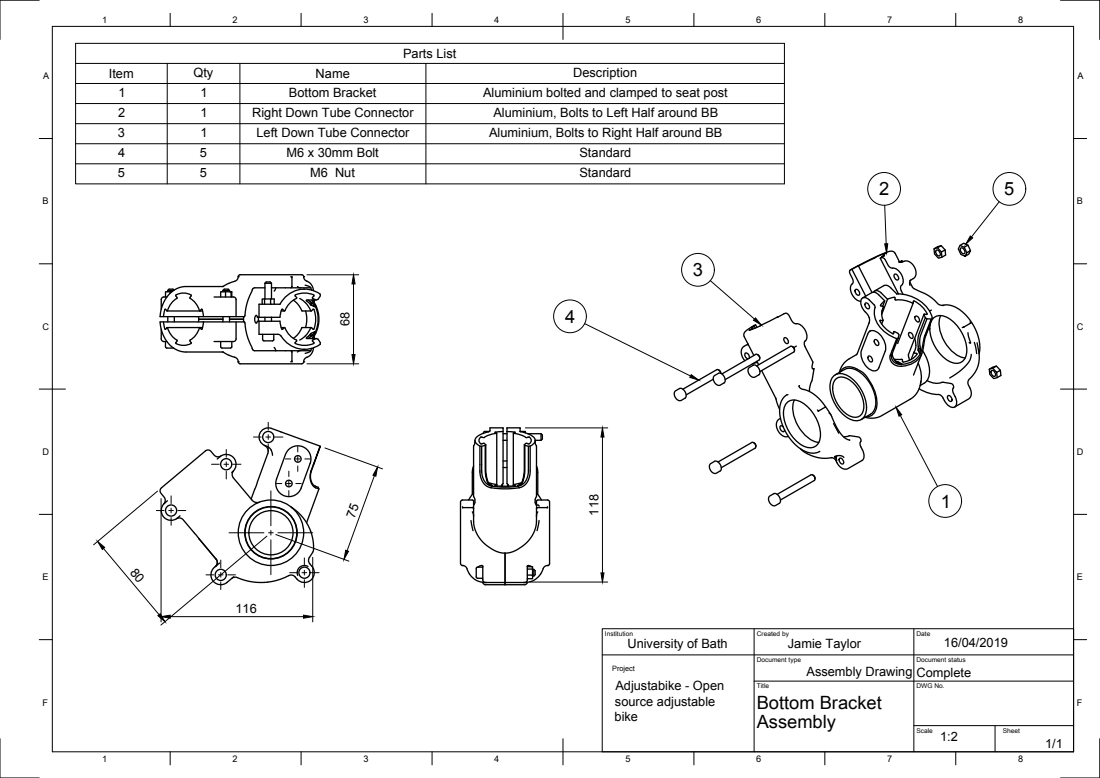
[picture p57: page 4]
Item; Qty; Name; Description; Bottom Bracket; Aluminium bolted and clamped to seat post; Right Down Tube Connector; Aluminium, Bolts to Left Half around BB; Left Down Tube Connector; Aluminium, Bolts to Right Half around BB; M6 x 30mm Bolt; Standard; M6 Nut; Institution; Created by; Date; Document type; Document status; Title; DWG No.; University of Bath; Jamie Taylor; Assembly Drawing; Project Adjustabike - Open source adjustable; Complete

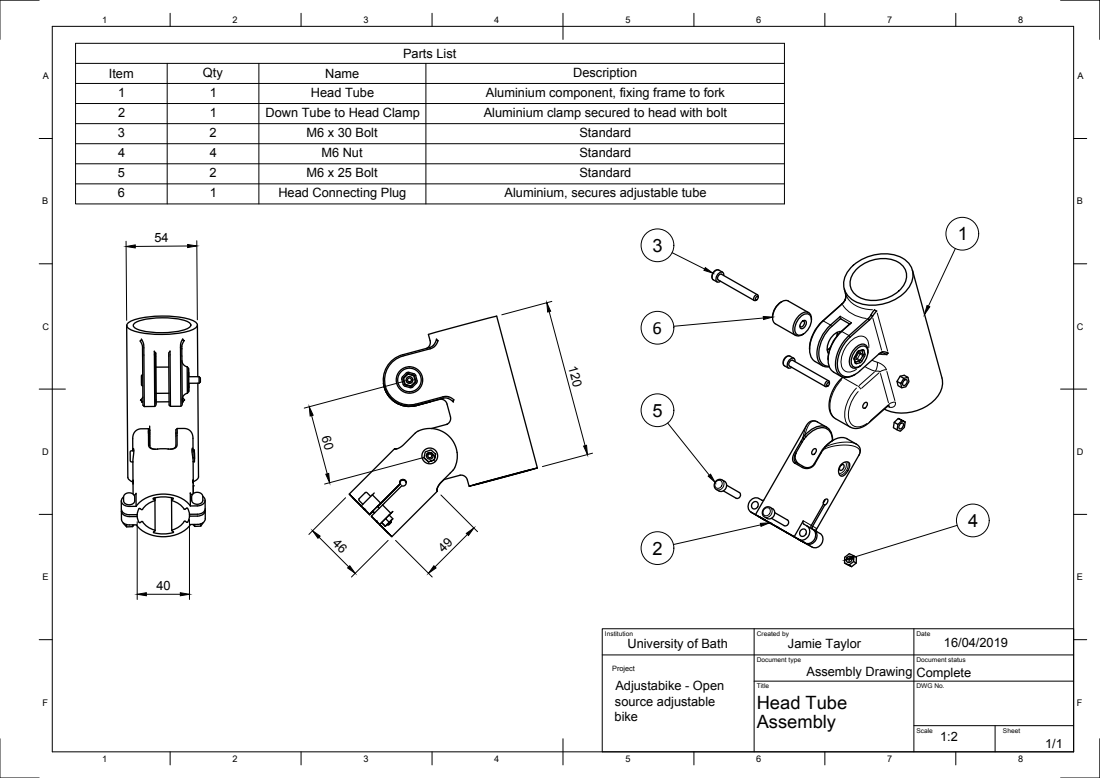
[picture p58: page 5]
Item; Qty; Name; Description; Head Tube; Aluminium component, fixing frame to fork; Down Tube to Head Clamp; Aluminium clamp secured to head with bolt; M6 x 30 Bolt; Standard; M6 Nut; M6 x 25 Bolt; Head Connecting Plug; Aluminium, secures adjustable tube; Institution; Created by; Date; Document type; Document status; Title; DWG No.; University of Bath; Jamie Taylor; Assembly Drawing; Project Adjustabike - Open source adjustable; Complete

3

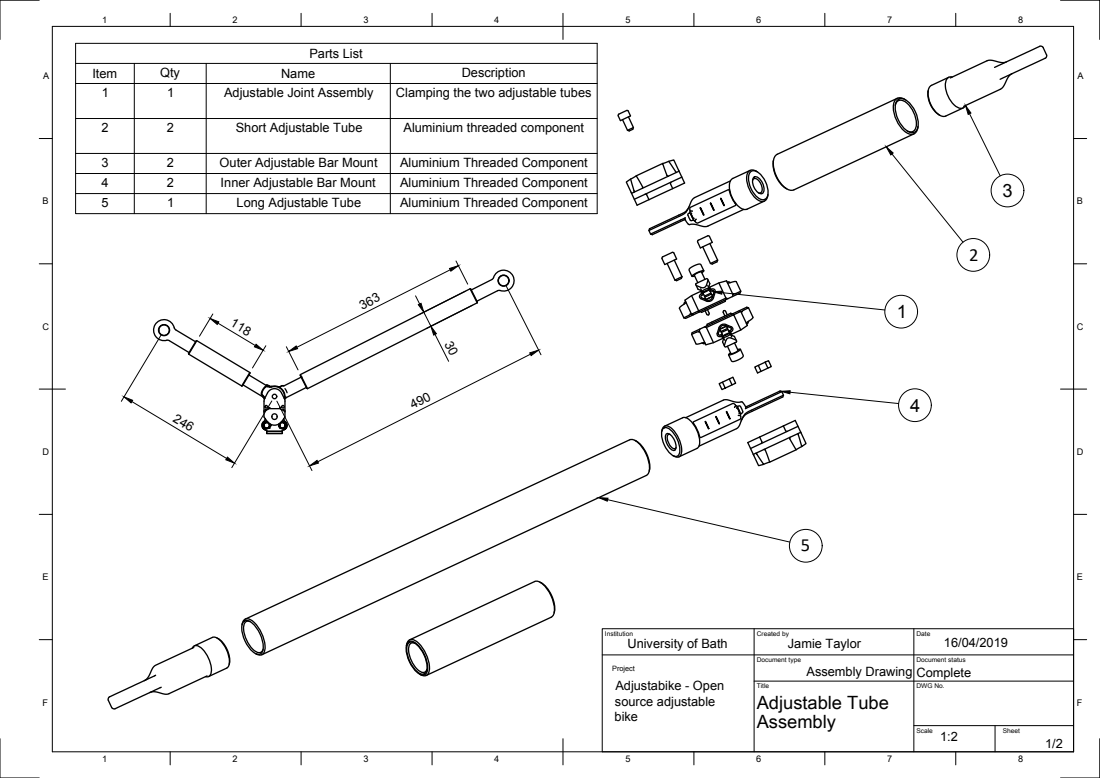
[picture p59: page 6]
Item; Qty; Name; Description; Adjustable Joint Assembly; Clamping the two adjustable tubes; Short Adjustable Tube; Aluminium threaded component; Outer Adjustable Bar Mount; Aluminium Threaded Component; Inner Adjustable Bar Mount; Long Adjustable Tube; Institution; Created by; Date; Document type; Document status; Title; DWG No.; University of Bath; Jamie Taylor; Assembly Drawing; Project Adjustabike - Open source adjustable; Complete; Adjustable Tube

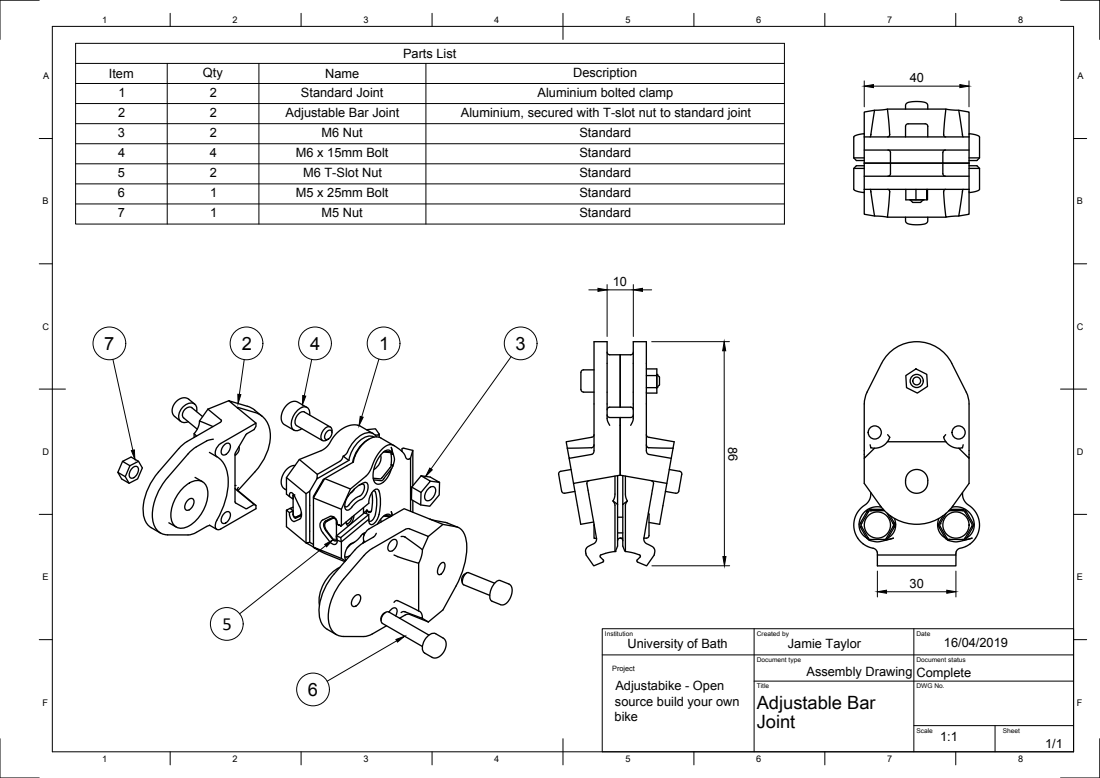
[picture p60: page 7]
Item; Qty; Name; Description; Standard Joint; Aluminium bolted clamp; Adjustable Bar Joint; Aluminium, secured with T-slot nut to standard joint; M6 Nut; Standard; M6 x 15mm Bolt; M6 T-Slot Nut; M5 x 25mm Bolt; M5 Nut; Institution; Created by; Date; Document type; Document status; Title; DWG No.; University of Bath; Jamie Taylor; Assembly Drawing; Complete; Joint; Adjustable Bar

Project
Adjustabike - Open
source build your own

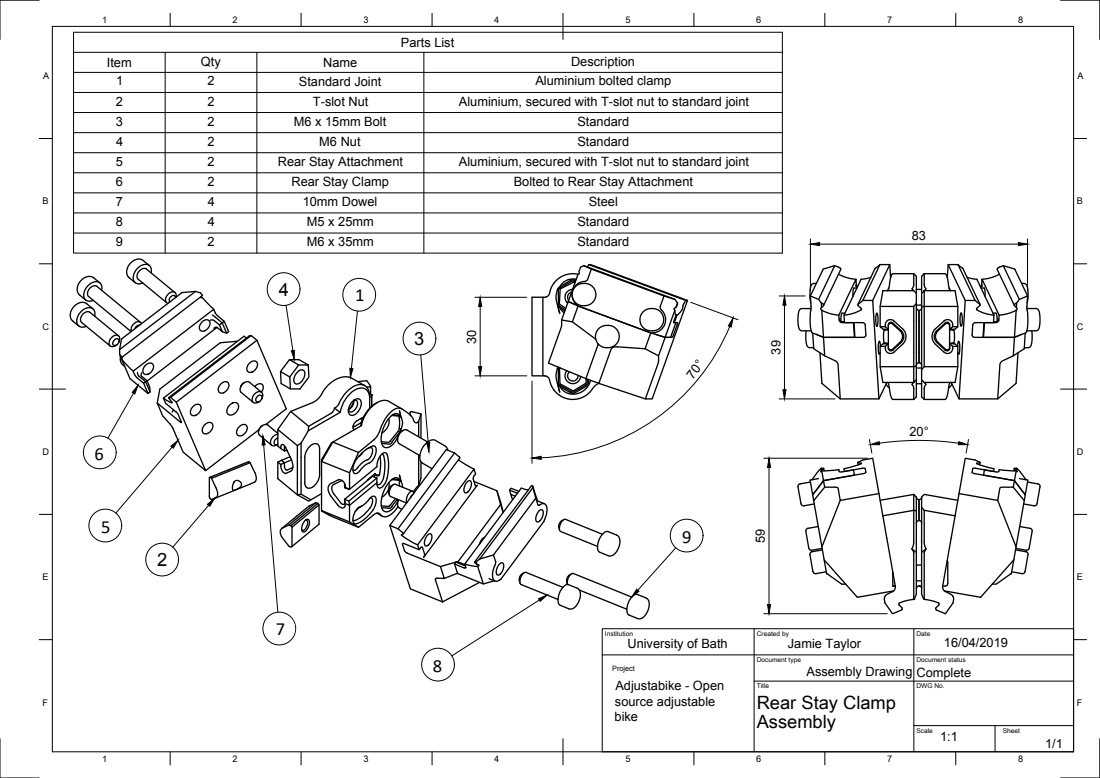
[picture p61: page 8]
Item; Qty; Name; Description; Standard Joint; Aluminium bolted clamp; T-slot Nut; Aluminium, secured with T-slot nut to standard joint; M6 x 15mm Bolt; Standard; M6 Nut; Rear Stay Attachment; Rear Stay Clamp; Bolted to Rear Stay Attachment; 10mm Dowel; Steel; Institution; Created by; Date; Document type; Document status; Title; DWG No.; University of Bath; Jamie Taylor; Assembly Drawing; Project Adjustabike - Open source adjustable; Complete

Rear Stay Clamp
